javiersoliso/rESPira/AVISO.md

# Aviso

rESPira es un instrumento de medición para uso personal y de investigación.
**No es un dispositivo médico.** No diagnostica, no trata y no sustituye a
ningún equipo clínico ni a la evaluación de un profesional de la salud.

El sensor MAX30102 y esta cadena de procesamiento no están calibrados contra
un equipo de referencia certificado. Los números que produce sirven para
observar tendencias y acoplamientos —cómo cambia tu ritmo cardiaco con la
respiración, por ejemplo— no para tomar decisiones clínicas.

Las figuras que acompañan a la documentación provienen de sesiones propias
del autor. Los registros crudos no se publican.
