javiersoliso/rESPira/(commit log)

2026-09-07 Estructura del repositorio, licencia y aviso
    El aviso deja claro que no es un dispositivo médico y que los registros
    crudos, por ser mediciones de una persona, no se publican.
2026-09-07 Firmware v9.1 para ESP32
    Adquisición del MAX30102 a 100 Hz, filtro Butterworth de segundo orden en
    cascada de biquads, detección de latido con puerta de calidad, control de
    ganancia acotado y lectura del potenciómetro por ADC1. El ESP32 sella cada
    lote con su propio reloj. Las credenciales de red viven en redes.h, fuera
    del repositorio; se incluye redes.h.ejemplo.
2026-09-07 Aplicación Android v10: la interfaz se muda al teléfono
    El ESP32 ya no sirve páginas — era lo que lo ahogaba mientras muestreaba.
    La parte nativa hace lo que un WebView no puede: descubrir el sensor por
    mDNS y barrido de subred, escribir el archivo de sesión a chorros, mantener
    la pantalla encendida y conectarse al punto de acceso del sensor.
2026-09-07 Herramientas de análisis en Python
    Análisis de sesión y de noche, variabilidad, fragmentación y cruce con el
    reloj. Las rutas a los datos se pasan por argumento o variable de entorno,
    no van escritas en el código.
2026-09-07 Documentación: esquema de conexiones, hardware, historial y hallazgos
    Incluye el esquema de conexiones en formato vectorial, la lista de
    materiales y la propuesta de carcasa impresa en 3D como siguiente paso.
2026-09-07 Documentar la clave del punto de acceso del sensor
    La clave del punto de acceso vive en dos sitios porque el firmware la levanta
    y la aplicación se conecta a él. Se deja anotado en ambos que tienen que
    coincidir, y por qué no se trata como un secreto de servidor.
2026-09-07 Instrucciones de publicación
    -
2026-09-07 Esquema de conexiones: cables rectos, sin cruces
    Los pines del ESP32 se alinean a la altura de su destino, así que las siete
    líneas quedan horizontales. Antes los tres del potenciómetro se cruzaban entre
    sí y con las etiquetas.
2026-09-07 Esquema de conexiones corregido: cables rectos
2026-10-24 Resultados medidos y resumen en inglés en el README
    Añade la tabla de cifras de la sesión nocturna (latidos, cobertura,
    frecuencia respiratoria y comparación con el reloj) con sus límites,
    un resumen en inglés y la sección de autor. Retira PUBLICAR.md, que eran
    notas internas de publicación.
2026-10-24 Guía de instalación del firmware acorde al repositorio
    Reescribe docs/INSTALAR.md: los pasos apuntan a firmware/ y a redes.h,
    sin rutas de un computador concreto, y las notas de la versión 9.1 pasan
    a tercera persona.
